agnunez/moco2/(threads)

Thread 1 (2020-12-31):

undefined reference to `sleepdelay(int)'

manuchSP, 2020-12-31:
No consigo compilar con la wifi inabilitada, me sale el error : "undefined reference to `sleepdelay(int)'"

... alguna idea de que estoy haciendo mal?

agnunez, 2021-01-01:
Comprueba que tienes todos ficheros en el directorio al compilar, en concreto el wifimanager.cpp pues en este fichero es donde está definida esa función void sleepdelay(int);

Closed 2021-01-02.
