agnunez/moco2/(commit log)

2020-12-10 esp01 pin tests
    There are 2 types of ESP01, with Led in GPIO2 and led in GPIO1
2020-12-11 Tested ESP01 and NodeMCU with CM1106 flash otional OLED
    Bug <500 ppm limit corrected to <400
    [Flashit.ino, nodemcu.h, oled.h]
2020-12-12 WifiOff option added
    Allows lower power consumption by switching off the WiFi radio
2020-12-14 Lower Power consumtion with Light_Sleep mode
2020-12-16 mydelay bug and Circuit Connection for CM1106 and ESP-01
    A bug corrected that prevented working with WiFi mode
    Some connection diagram added
    [Flashit.ino]
2020-12-20 Python CM1106 calibration added, and README updated
2020-12-21 Update CM1106calibration.py
    Print df3 byte containing range mode and heating bits
2020-12-23 define WiFi option only when needed
    It allows WiFi but prevents sleep delay low consumption
    [CM1106calibration.py, Flashit.ino]
2021-01-01 OLED text bug corrected with init every cycle
    Also sleepdelay bug corrected not applied for ppm > 1000 causing a long delay without measures
    [Flashit.ino, esp01.h, oled.h, wifimanager.cpp]
2021-01-02 Update CM1106 python calibration with ABC options
    base value (def=400), number of days(def:7), Auto Cal(def=on)
2021-02-22 Update CM1106calibration.py
    ppm print loop with ctrl-c for menu
